friedpies/kelpie-synth-hardware/ASSETS/Untitled-1.png

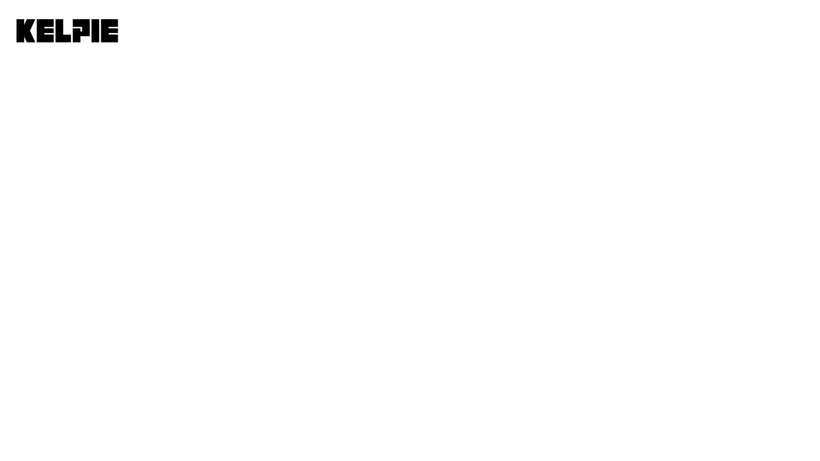
ASSETS/Untitled-1.png
