friedpies/kelpie-synth-hardware/sirin-clone-mcu.brd

## EAGLE design sirin-clone-mcu.brd (2019-03-26)

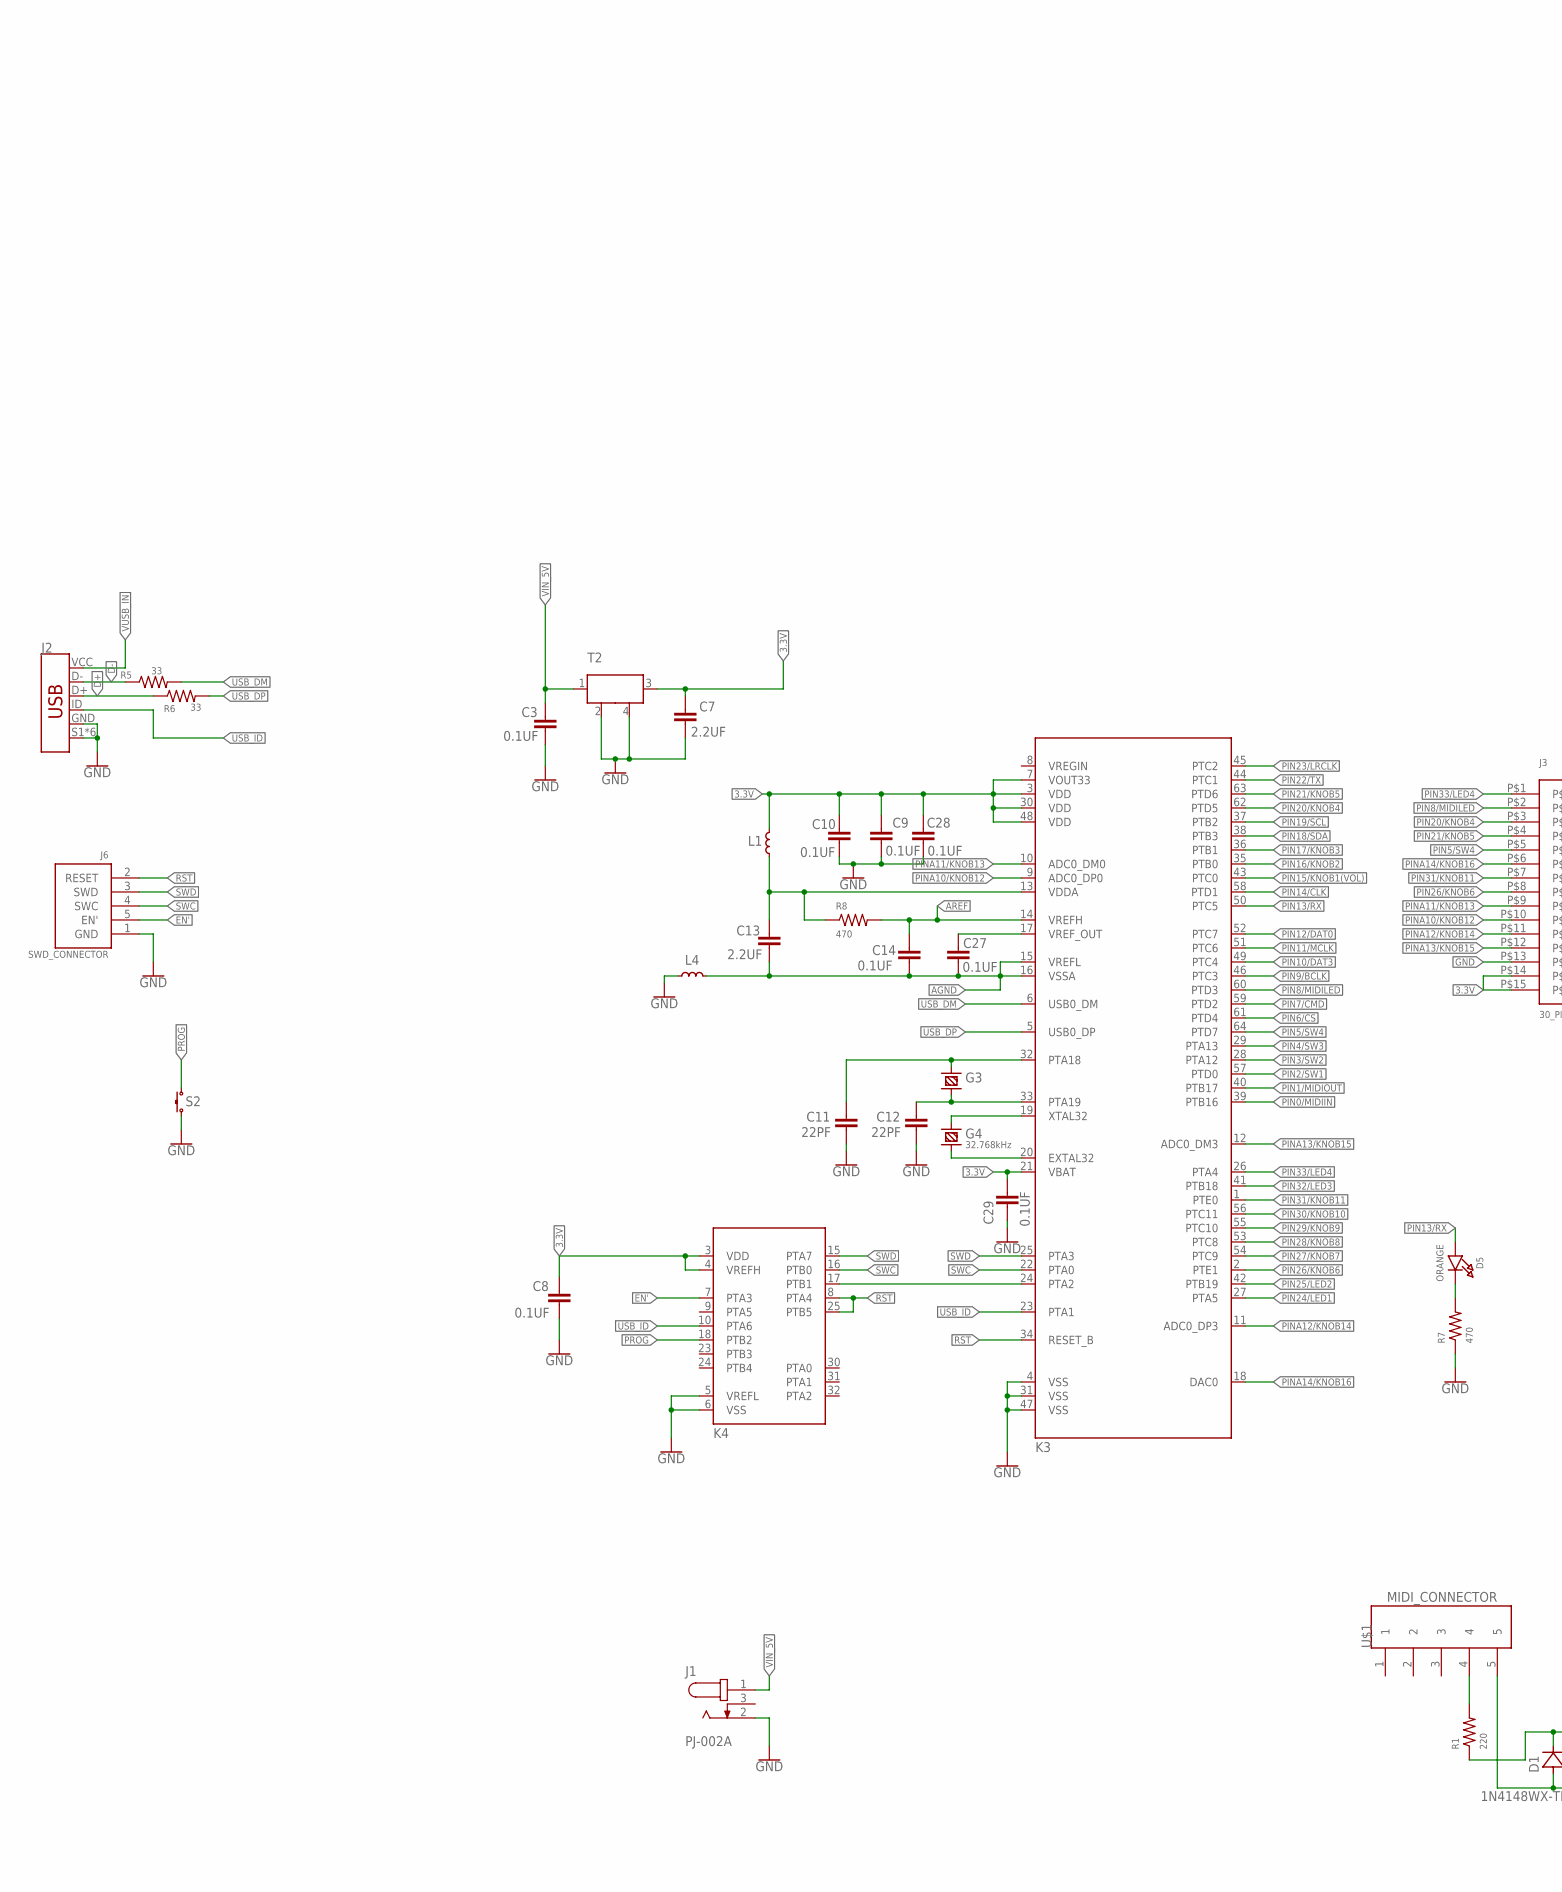
[picture p2: schematic sirin-clone-mcu.sch, part in row 1, column 1]

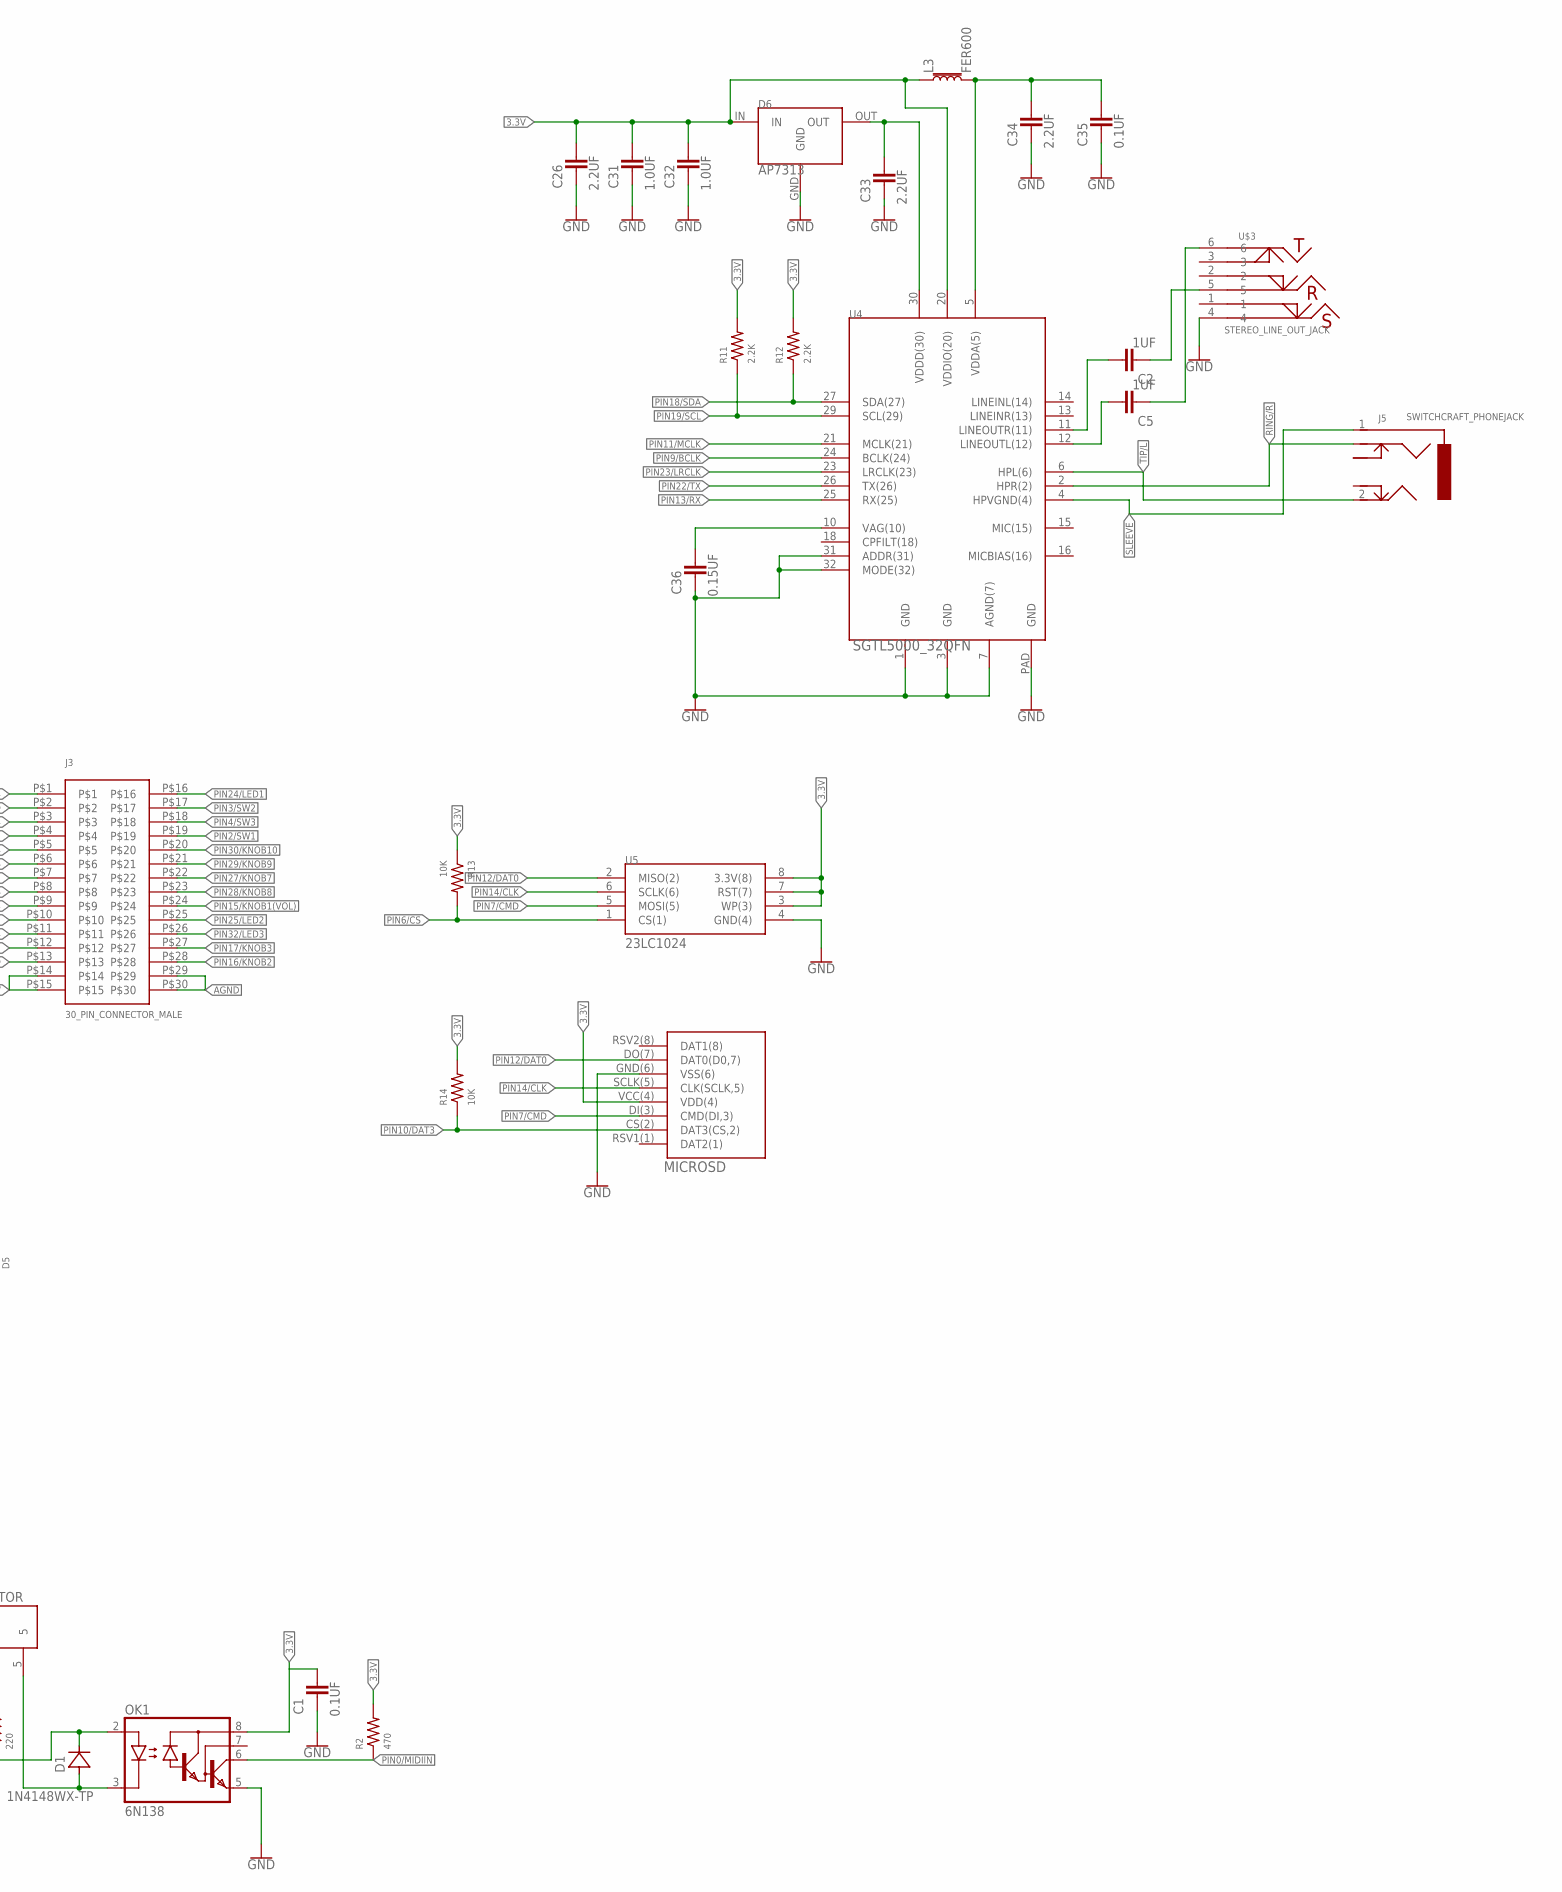
[picture p3: schematic sirin-clone-mcu.sch, part in row 1, column 2]

Parts:
C1, C3, C8, C9, C10, C14, C27, C28, C29, C35: 0.1UF; C_0805
C2, C5: 1UF; C_0805
C7, C13, C26, C33, C34: 2.2UF; C_0805
C11, C12: 22PF; C_0805
C31, C32: 1.0UF; C_0805
C36: 0.15UF; C_0805
D1: 1N4148WX-TP; SOD323
D5: ORANGE; CHIPLED_0805
D6: AP7313; SOT23-3
G3: 16MHz; HC49US
G4: 32.768kHz; TC26H
J1: PJ-002A; CUI_PJ-002A
J2: USB_MICRO-B; FCI_10103594-0001LF
J3: 30_PIN_CONNECTOR_MALE; MOLEX_30PINCONNECTOR_2MM
J5: SWITCHCRAFT_PHONEJACK; STEREO_JACK_2SWITCH
J6: SWD_CONNECTOR; 1X5HEADER
K3: MK20DX256VLH7; LQFP64-05
K4: MKL04Z32VLC4; LQFP32-08
L1, L4: FERRITE600_TEENSY; L0603
L3: FER600; 0805
OK1: 6N138; DIP8
R1: 220; 0805
R2, R7, R8: 470; 0805
R5, R6: 33; 0805
R11, R12: 2.2K; 0805
R13, R14: 10K; 0805
S2: TACT_SWITCH; SWITCH_PTS820
T2: MCP1825S; SOT223
U4: SGTL5000_32QFN; QFN-32-5MM
U5: 23LC1024; TSSOP8
U$1: MIDI_CONNECTOR; DIN_SDS_50J
U$3: STEREO_LINE_OUT_JACK; AMPHENOL_STEREO_JACK
U$6: MICROSD; MICRO-SD-SOCKET

Connections:
3.3V: C1.+, C7.+, C8.+, C9.+, C10.+, C26.+, C28.+, C29.+, C31.+, C32.+, D6.IN, J3.P$14, J3.P$15, K3.3 (VDD), K3.7 (VOUT33), K3.21 (VBAT), K3.30 (VDD), K3.48 (VDD), K4.3 (VDD), K4.4 (VREFH), L1.2, L3.1, OK1.8 (VCC), R2.2, R11.2, R12.2, R13.1, R14.2, T2.3 (OUT), U4.20 (VDDIO(20)), U5.3 (WP(3)), U5.7 (RST(7)), U5.8 (3.3V(8)), U$6.VCC(4) (VDD(4))
AGND: C13.-, C14.-, C27.-, J3.P$29, J3.P$30, K3.15 (VREFL), K3.16 (VSSA), L4.2
AREF: C14.+, K3.14 (VREFH), R8.2
D+: J2.D+, R6.1
D-: J2.D-, R5.1
EN': J6.5 (EN'), K4.7 (PTA3)
GND: C1.-, C3.-, C7.-, C8.-, C9.-, C10.-, C11.-, C12.-, C26.-, C28.-, C29.-, C31.-, C32.-, C33.-, C34.-, C35.-, C36.-, D6.GND, J1.2, J2.GND, J2.S1 (SHIELD), J2.S2 (SHIELD), J2.S3 (SHIELD), J2.S4 (SHIELD), J2.S5 (SHIELD), J2.S6 (SHIELD), J3.P$13, J6.1 (GND), K3.4 (VSS), K3.31 (VSS), K3.47 (VSS), K4.5 (VREFL), K4.6 (VSS), L4.1, OK1.5 (GND), R7.1, S2.2 (3), T2.2 (PAD), T2.4 (GND), U4.1 (GND), U4.3 (GND), U4.7 (AGND(7)), U4.31 (ADDR(31)), U4.32 (MODE(32)), U4.PAD (GND), U5.4 (GND(4)), U$3.4, U$6.GND(6) (VSS(6))
unnamed: D1.A, OK1.3 (C), U$1.5
unnamed: R1.2, U$1.4
unnamed: D1.C, OK1.2 (A), R1.1
unnamed: C5.+, U4.12 (LINEOUTL(12))
unnamed: C2.+, U4.11 (LINEOUTR(11))
unnamed: C2.-, U$3.5
unnamed: K3.24 (PTA2), K4.17 (PTB1)
unnamed: D5.C, R7.2
unnamed: G4.1 (2), K3.20 (EXTAL32)
unnamed: G4.2 (1), K3.19 (XTAL32)
unnamed: C12.+, G3.2, K3.33 (PTA19)
unnamed: C11.+, G3.1, K3.32 (PTA18)
unnamed: C13.+, K3.13 (VDDA), L1.1, R8.1
unnamed: C27.+, K3.17 (VREF_OUT)
unnamed: C5.-, U$3.6
unnamed: C36.+, U4.10 (VAG(10))
unnamed: C33.+, D6.OUT, U4.30 (VDDD(30))
unnamed: C34.+, C35.+, L3.2, U4.5 (VDDA(5))
PIN0/MIDIIN: K3.39 (PTB16), OK1.6 (VO), R2.1
PIN1/MIDIOUT: K3.40 (PTB17)
PIN2/SW1: J3.P$19, K3.57 (PTD0)
PIN3/SW2: J3.P$17, K3.28 (PTA12)
PIN4/SW3: J3.P$18, K3.29 (PTA13)
PIN5/SW4: J3.P$5, K3.64 (PTD7)
PIN6/CS: K3.61 (PTD4), R13.2, U5.1 (CS(1))
PIN7/CMD: K3.59 (PTD2), U5.5 (MOSI(5)), U$6.DI(3) (CMD(DI,3))
PIN8/MIDILED: J3.P$2, K3.60 (PTD3)
PIN9/BCLK: K3.46 (PTC3), U4.24 (BCLK(24))
PIN10/DAT3: K3.49 (PTC4), R14.1, U$6.CS(2) (DAT3(CS,2))
PIN11/MCLK: K3.51 (PTC6), U4.21 (MCLK(21))
PIN12/DAT0: K3.52 (PTC7), U5.2 (MISO(2)), U$6.DO(7) (DAT0(D0,7))
PIN13/RX: D5.A, K3.50 (PTC5), U4.25 (RX(25))
PIN14/CLK: K3.58 (PTD1), U5.6 (SCLK(6)), U$6.SCLK(5) (CLK(SCLK,5))
PIN15/KNOB1(VOL): J3.P$24, K3.43 (PTC0)
PIN16/KNOB2: J3.P$28, K3.35 (PTB0)
PIN17/KNOB3: J3.P$27, K3.36 (PTB1)
PIN18/SDA: K3.38 (PTB3), R12.1, U4.27 (SDA(27))
PIN19/SCL: K3.37 (PTB2), R11.1, U4.29 (SCL(29))
PIN20/KNOB4: J3.P$3, K3.62 (PTD5)
PIN21/KNOB5: J3.P$4, K3.63 (PTD6)
PIN22/TX: K3.44 (PTC1), U4.26 (TX(26))
PIN23/LRCLK: K3.45 (PTC2), U4.23 (LRCLK(23))
PIN24/LED1: J3.P$16, K3.27 (PTA5)
PIN25/LED2: J3.P$25, K3.42 (PTB19)
PIN26/KNOB6: J3.P$8, K3.2 (PTE1)
PIN27/KNOB7: J3.P$22, K3.54 (PTC9)
PIN28/KNOB8: J3.P$23, K3.53 (PTC8)
PIN29/KNOB9: J3.P$21, K3.55 (PTC10)
PIN30/KNOB10: J3.P$20, K3.56 (PTC11)
PIN31/KNOB11: J3.P$7, K3.1 (PTE0)
PIN32/LED3: J3.P$26, K3.41 (PTB18)
PIN33/LED4: J3.P$1, K3.26 (PTA4)
PINA10/KNOB12: J3.P$10, K3.9 (ADC0_DP0)
PINA11/KNOB13: J3.P$9, K3.10 (ADC0_DM0)
PINA12/KNOB14: J3.P$11, K3.11 (ADC0_DP3)
PINA13/KNOB15: J3.P$12, K3.12 (ADC0_DM3)
PINA14/KNOB16: J3.P$6, K3.18 (DAC0)
PROG: K4.18 (PTB2), S2.1
RING/R: J5.3 (RING(3)), U4.2 (HPR(2))
RST: J6.2 (RESET), K3.34 (RESET_B), K4.8 (PTA4), K4.25 (PTB5)
SLEEVE: J5.1 (SLEEVE(1)), U4.4 (HPVGND(4))
SWC: J6.4 (SWC), K3.22 (PTA0), K4.16 (PTB0)
SWD: J6.3 (SWD), K3.25 (PTA3), K4.15 (PTA7)
TIP/L: J5.2 (TIP(2)), U4.6 (HPL(6))
USB_DM: K3.6 (USB0_DM), R5.2
USB_DP: K3.5 (USB0_DP), R6.2
USB_ID: J2.ID, K3.23 (PTA1), K4.10 (PTA6)
VIN_5V: C3.+, J1.1, T2.1 (IN)
VUSB_IN: J2.VCC (VBUS)

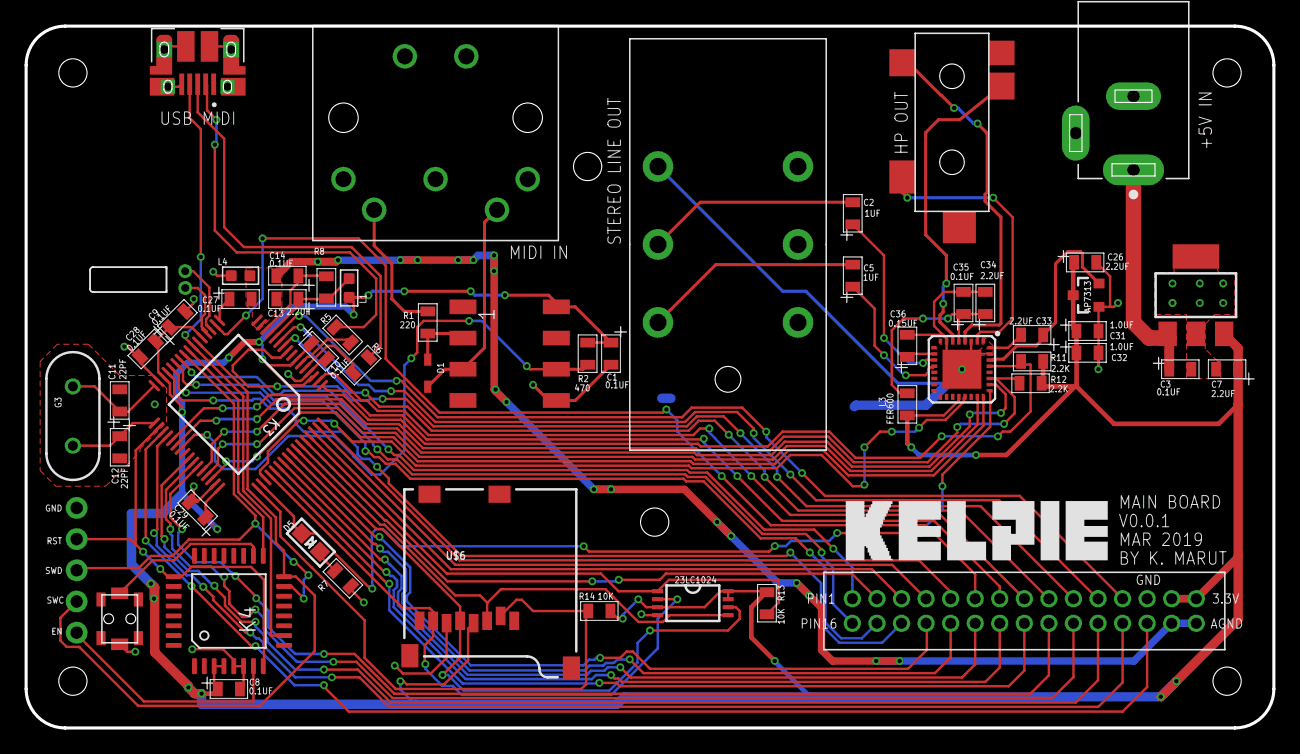
[picture p4: board sirin-clone-mcu.brd from above]

Board: 2 copper layers, 101.6 x 57.1 mm, 55 parts (0 on the bottom side), 74 nets.
