friedpies/kelpie-synth-hardware/sirin-clone-schematic.brd

## EAGLE design sirin-clone-schematic.brd (2019-03-26)

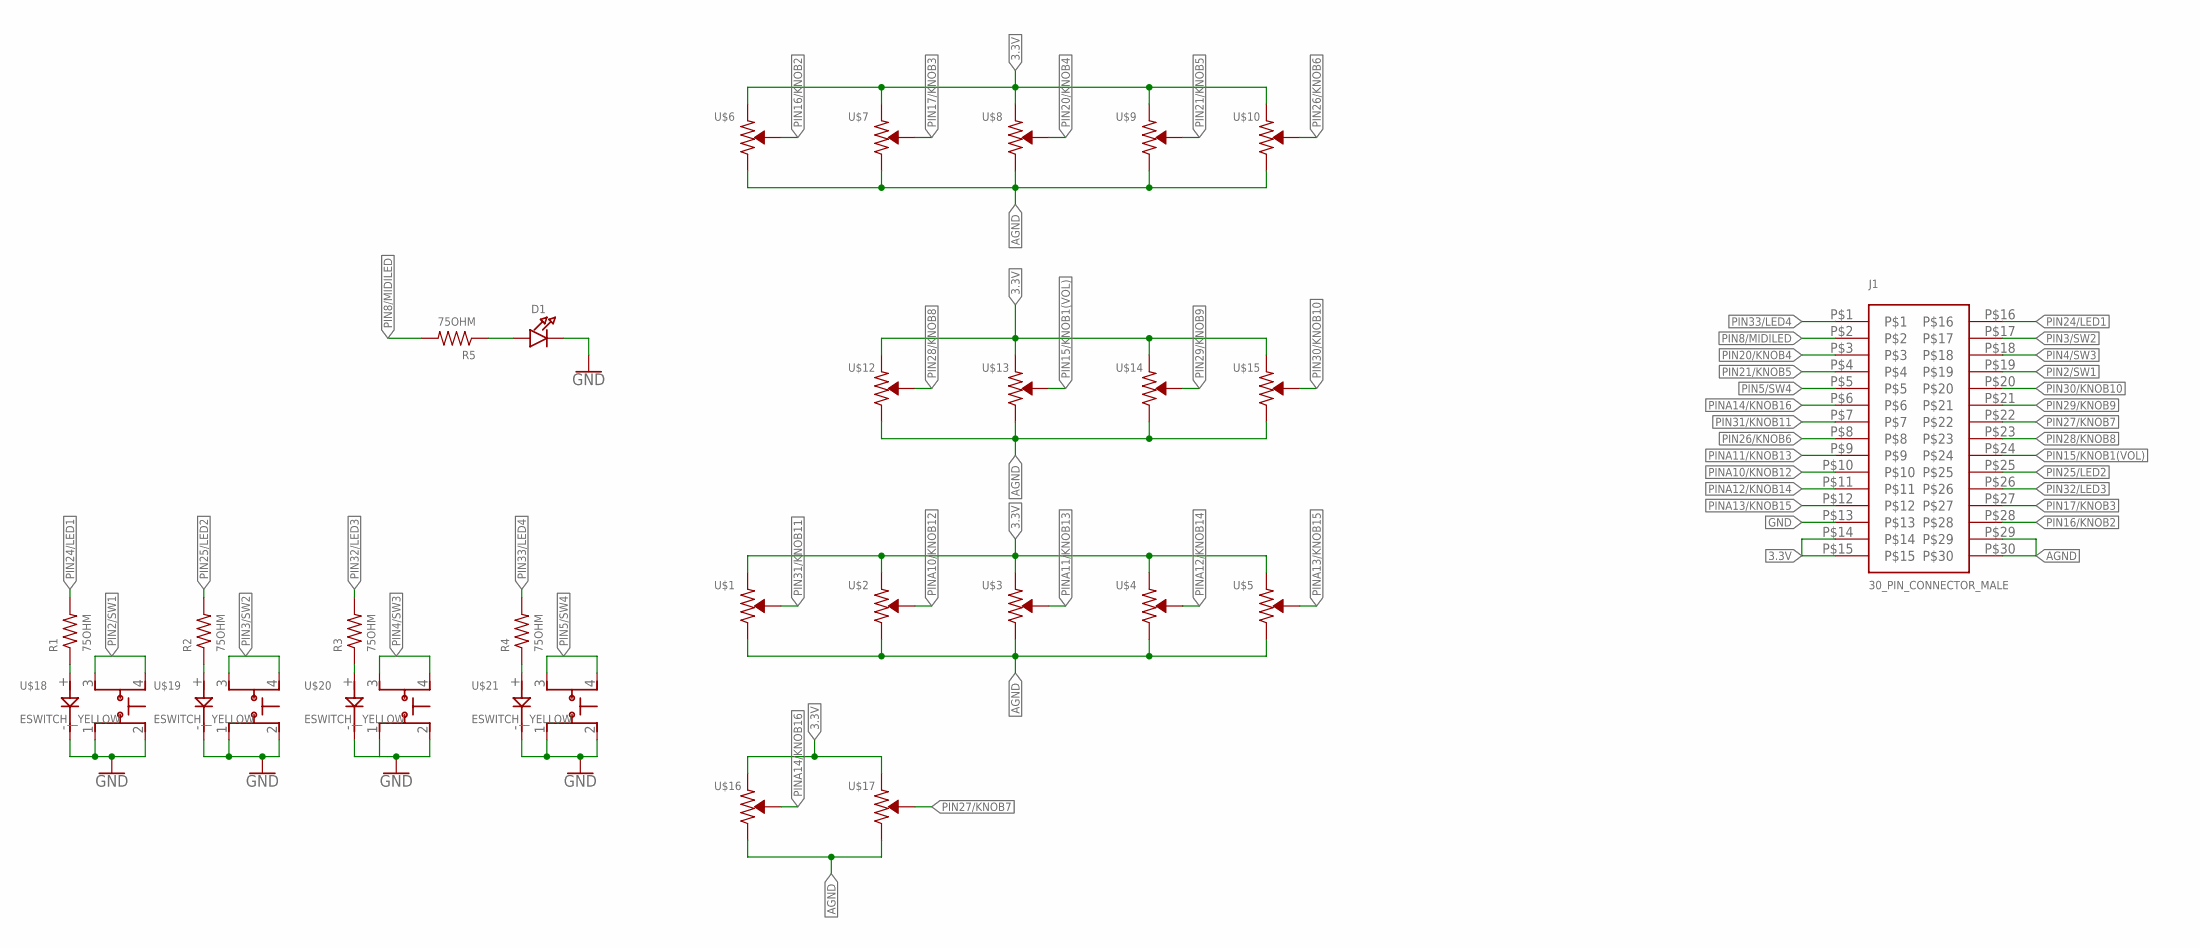
[picture p5: schematic sirin-clone-schematic.sch]

Parts:
D1: LED_RED0805; CHIPLED_0805
J1: 30_PIN_CONNECTOR_MALE; MOLEX_30PINCONNECTOR_2MM
R1, R2, R3, R4, R5: 75OHM; 0805
U$1, U$2, U$3, U$4, U$5, U$6, U$7, U$8, U$9, U$10, U$12, U$13, U$14, U$15, U$16, U$17: BOURNS_10K_POTENTIOMETER; BOURNS_PTV09
U$18, U$19, U$20, U$21: ESWITCH__YELLOW; ESWITCH_TL1240YQ1JCLR

Connections:
3.3V: J1.P$14, J1.P$15, U$1.1, U$2.1, U$3.1, U$4.1, U$5.1, U$6.1, U$7.1, U$8.1, U$9.1, U$10.1, U$12.1, U$13.1, U$14.1, U$15.1, U$16.1, U$17.1
AGND: J1.P$29, J1.P$30, U$1.3, U$2.3, U$3.3, U$4.3, U$5.3, U$6.3, U$7.3, U$8.3, U$9.3, U$10.3, U$12.3, U$13.3, U$14.3, U$15.3, U$16.3, U$17.3
GND: D1.C, J1.P$13, U$18.1, U$18.2, U$18.-, U$19.1, U$19.2, U$19.-, U$20.1, U$20.2, U$20.-, U$21.1, U$21.2, U$21.-
unnamed: R1.1, U$18.+
unnamed: R2.1, U$19.+
unnamed: R3.1, U$20.+
unnamed: R4.1, U$21.+
unnamed: D1.A, R5.1
PIN2/SW1: J1.P$19, U$18.3, U$18.4
PIN3/SW2: J1.P$17, U$19.3, U$19.4
PIN4/SW3: J1.P$18, U$20.3, U$20.4
PIN5/SW4: J1.P$5, U$21.3, U$21.4
PIN8/MIDILED: J1.P$2, R5.2
PIN15/KNOB1(VOL): J1.P$24, U$13.2
PIN16/KNOB2: J1.P$28, U$6.2
PIN17/KNOB3: J1.P$27, U$7.2
PIN20/KNOB4: J1.P$3, U$8.2
PIN21/KNOB5: J1.P$4, U$9.2
PIN24/LED1: J1.P$16, R1.2
PIN25/LED2: J1.P$25, R2.2
PIN26/KNOB6: J1.P$8, U$10.2
PIN27/KNOB7: J1.P$22, U$17.2
PIN28/KNOB8: J1.P$23, U$12.2
PIN29/KNOB9: J1.P$21, U$14.2
PIN30/KNOB10: J1.P$20, U$15.2
PIN31/KNOB11: J1.P$7, U$1.2
PIN32/LED3: J1.P$26, R3.2
PIN33/LED4: J1.P$1, R4.2
PINA10/KNOB12: J1.P$10, U$2.2
PINA11/KNOB13: J1.P$9, U$3.2
PINA12/KNOB14: J1.P$11, U$4.2
PINA13/KNOB15: J1.P$12, U$5.2
PINA14/KNOB16: J1.P$6, U$16.2

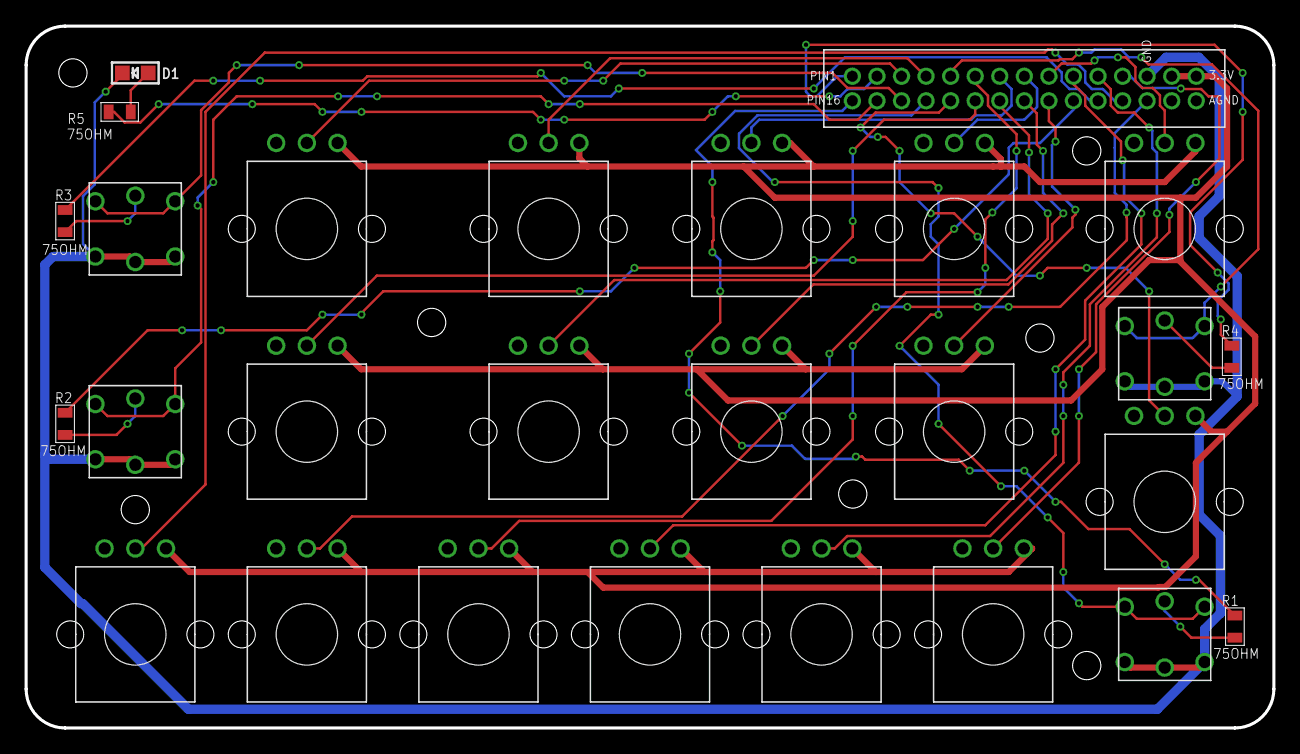
[picture p6: board sirin-clone-schematic.brd from above]

Board: 2 copper layers, 101.6 x 57.1 mm, 27 parts (0 on the bottom side), 33 nets.
