friedpies/kelpie-synth-hardware/(commit log)

2019-03-03 fix folder structure and push
    [sirin-clone-schematic.brd, sirin-clone-schematic.sch]
2019-03-13 work on lower pcb
    [sirin-clone-mcu.brd, sirin-clone-mcu.sch, sirin-clone-schematic.brd]
2019-03-15 add midi
    [sirin-clone-mcu.brd, sirin-clone-mcu.sch, sirin-clone-schematic.brd]
2019-03-16 work on connector options
    [sirin-clone-mcu.brd, sirin-clone-mcu.sch]
2019-03-19 more routing
    [sirin-clone-mcu.brd, sirin-clone-mcu.sch]
2019-03-20 lots o' routing
    [sirin-clone-mcu.brd, sirin-clone-mcu.sch, sirin-clone-schematic.brd, sirin-clone-schematic.sch]
2019-03-21 ready for gerbers
    [sirin-clone-mcu.brd, sirin-clone-mcu.sch, sirin-clone-schematic.brd, sirin-clone-schematic.sch]
2019-03-26 adding bom attributes
    [sirin-clone-mcu.brd, sirin-clone-mcu.sch, sirin-clone-schematic.brd, sirin-clone-schematic.sch]
2019-03-26 placed bom order
    [CONTROL.csv, MCU.csv, control.xlsx, kelpieMCU.xlsx, mcu.xlsx, sirin-clone-mcu.brd, sirin-clone-mcu.csv, sirin-clone-mcu.sch]
